WendyLiDev/Mirror/(commit log)

2017-11-10 outputs brightness number on leds in portb
2017-11-16 added pwm
2017-11-16 Add files via upload
    Light detection and auto adjust works. Buttons work but are not properly adjusting the brightness.
2017-11-16 Add files via upload
    Fixed bugs in incrementing and decrementing the manualOffset value with B0 and B1. There is still an issue with decrementing below 0, try adjusting the code in adjustLight() to not increment or decrement past brightness bounds. Also, brightness value is hardset at 5 currently for debugging purposes.
    [Lights.c]
